Isno-Open/OpenSuperRF/enclosures/render_capot.png

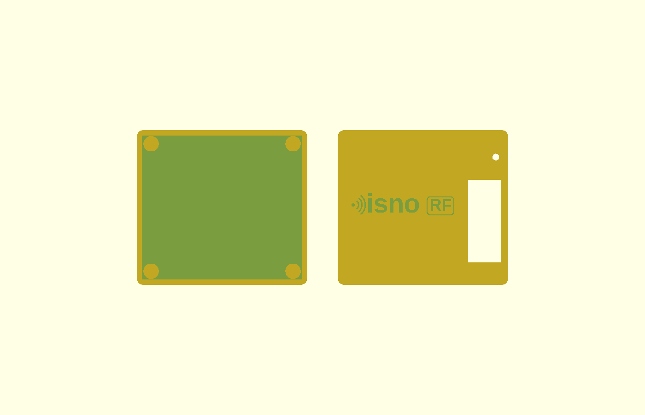
enclosures/render_capot.png
