Isno-Open/OpenSuperRF/enclosures/render_super.png

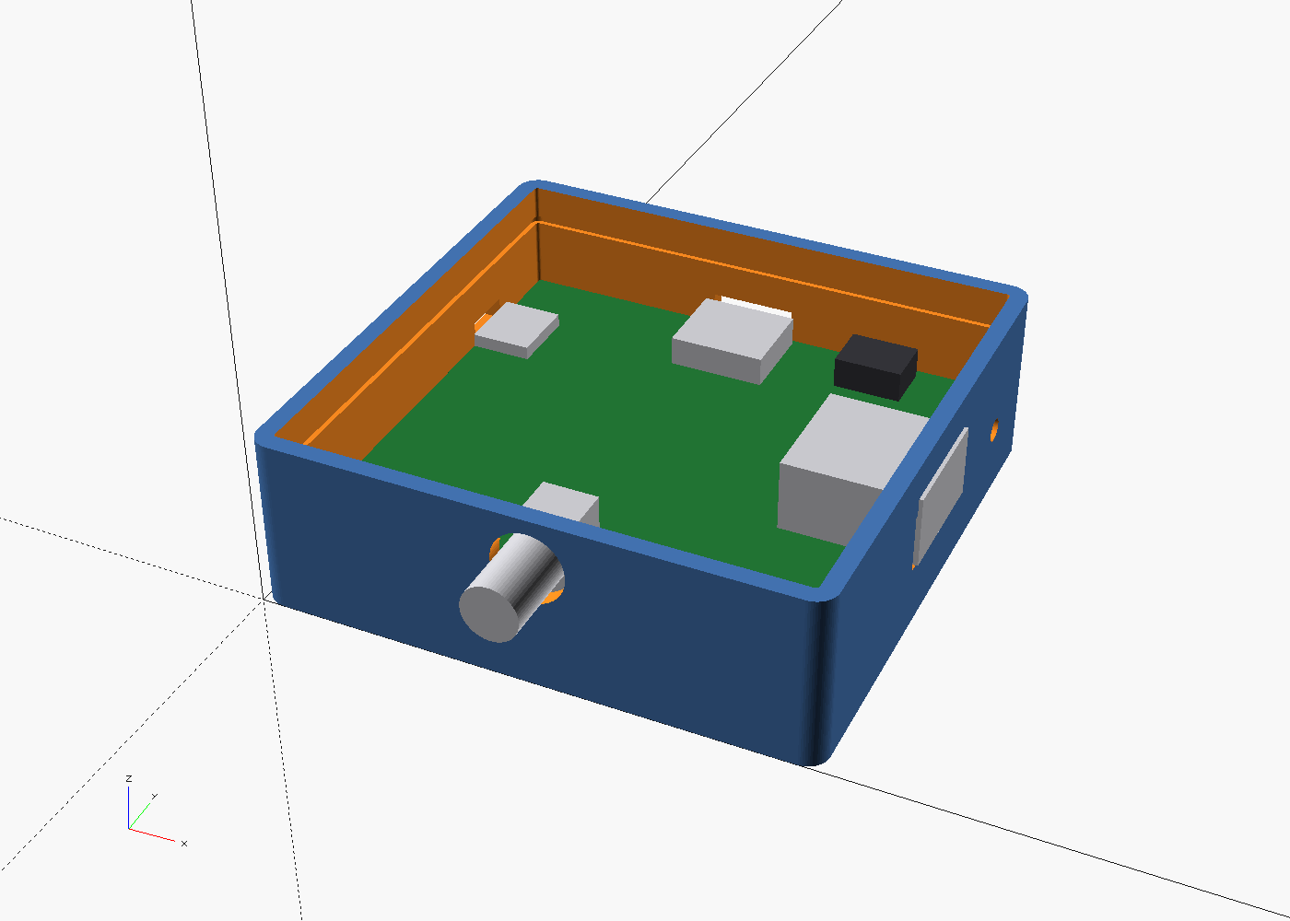
enclosures/render_super.png
