Isno-Open/OpenSuperRF/fab/isno-super-3d.png

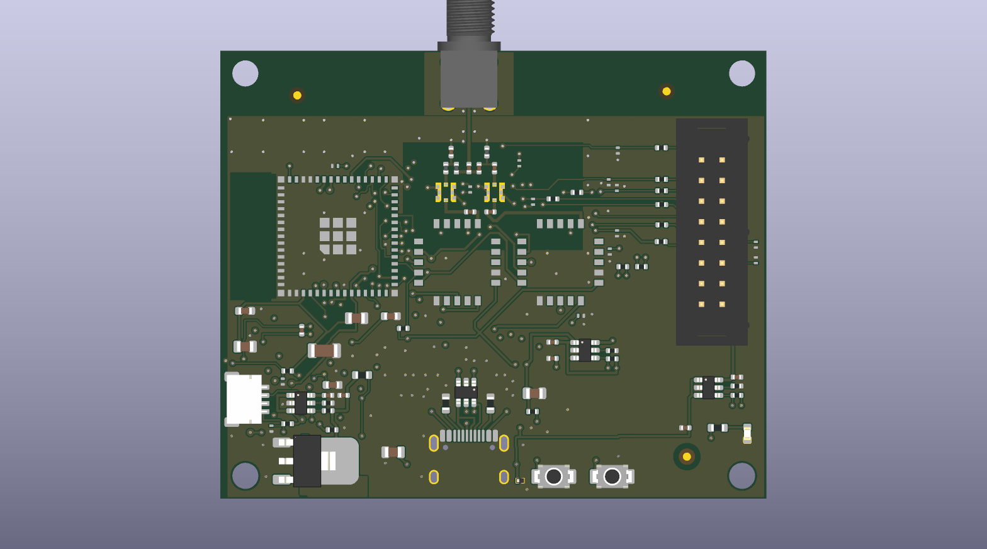
fab/isno-super-3d.png
