Isno-Open/OpenSuperRF/images/boitier-super.png

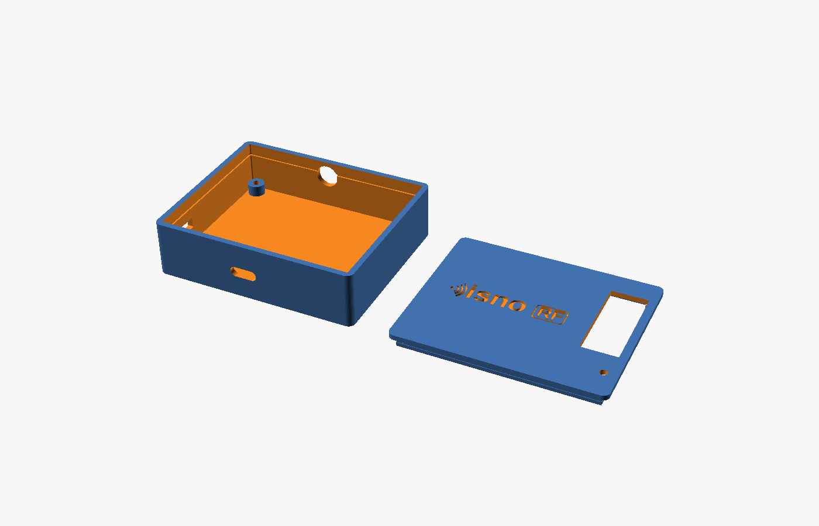
images/boitier-super.png
