Isno-Open/OpenSuperRF/images/isno-super-evt-dos.webp

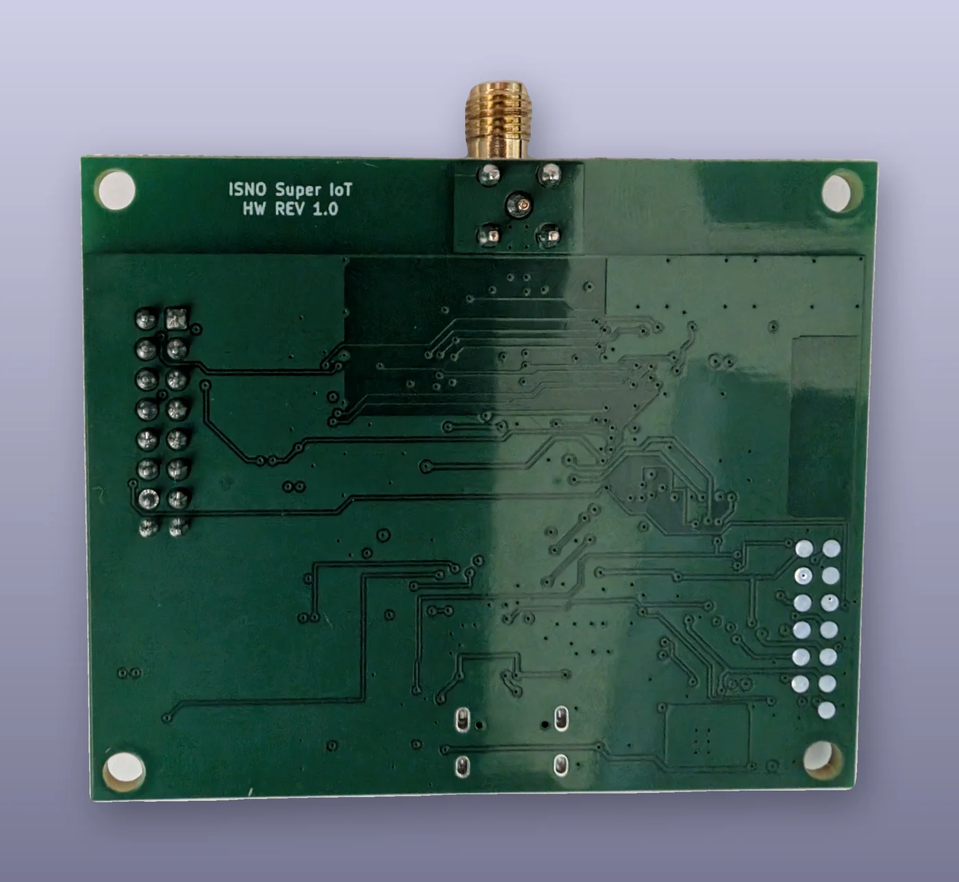
images/isno-super-evt-dos.webp
