Isno-Open/OpenSuperRF/images/render_named.png

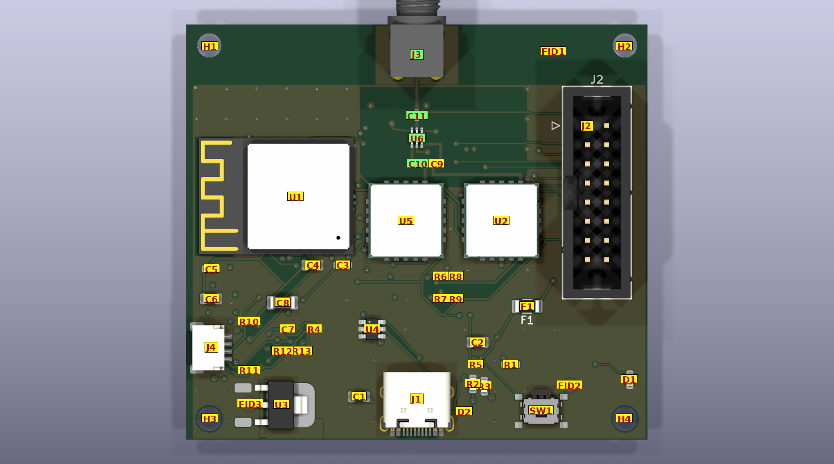
images/render_named.png
