Isno-Open/OpenSuperRF/images/rendu-3d-final.png

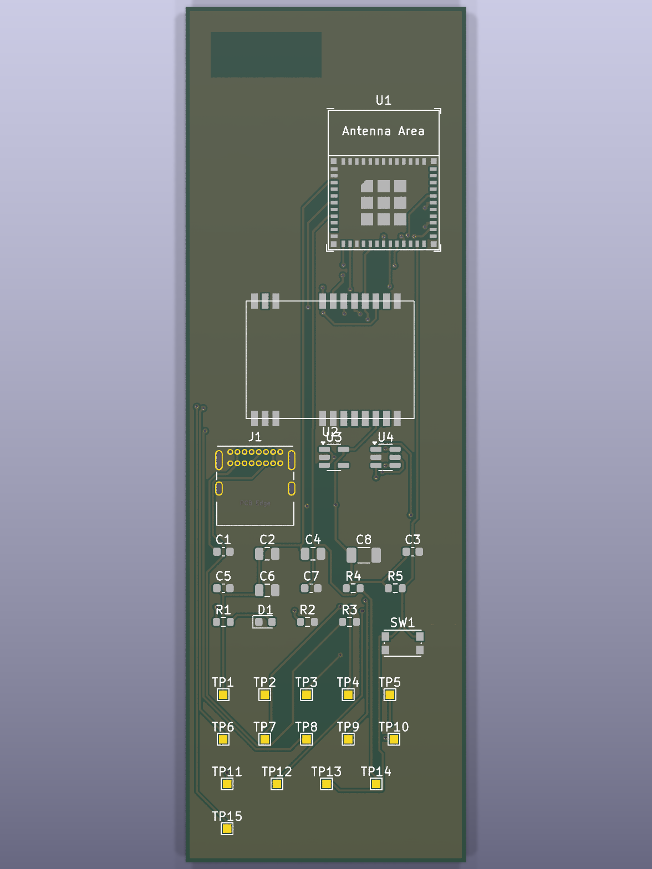
images/rendu-3d-final.png
