Isno-Open/OpenSuperRF/images/super-bottom.png

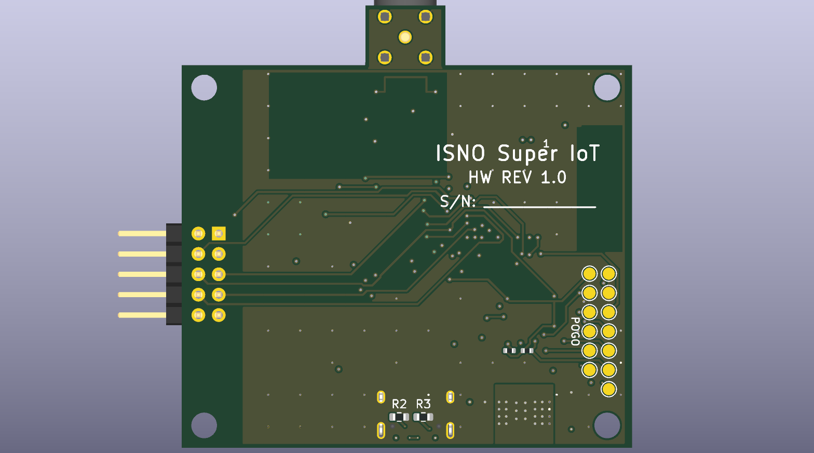
images/super-bottom.png
