Isno-Open/OpenSuperRF/images/super-dos.png

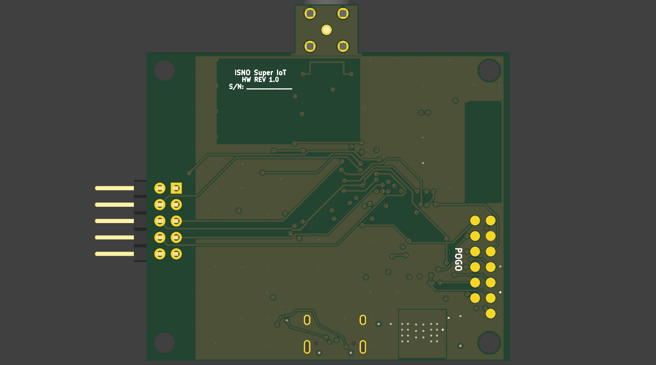
images/super-dos.png
