Isno-Open/OpenSuperRF/images/super-face.png

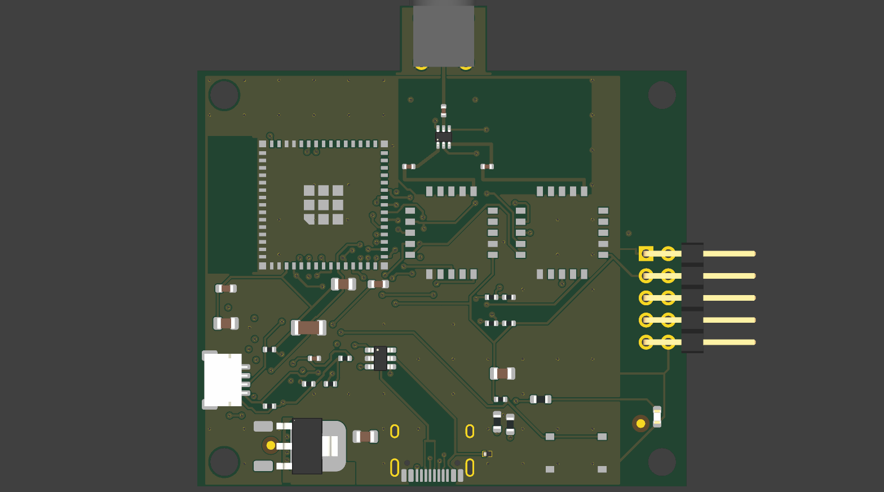
images/super-face.png
