Isno-Open/OpenSuperRF/images/super-top.png

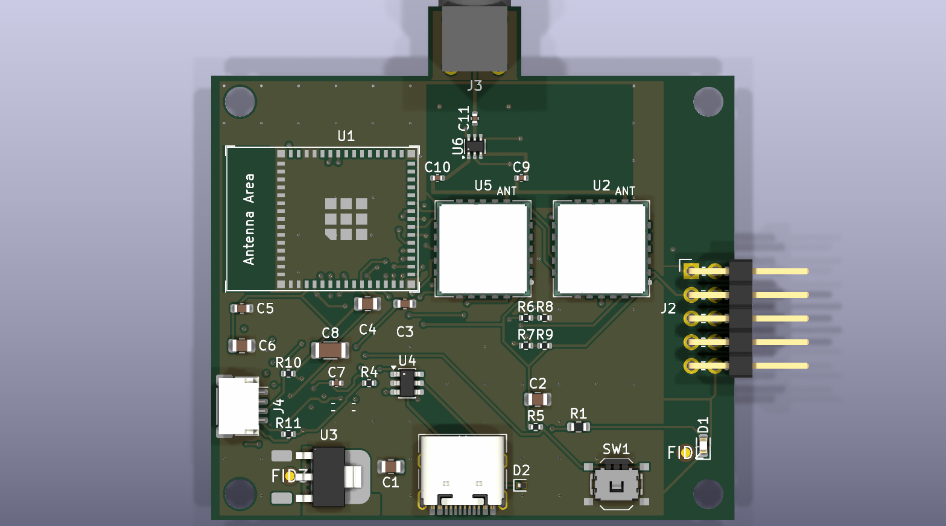
images/super-top.png
