Isno-Open/OpenSuperRF/docs/openprofalux-bom.csv

Reference | Value | Footprint | QUANTITY
C1 | 1uF | Capacitor_SMD:C_0603_1608Metric | 1
C2 | 22uF | Capacitor_SMD:C_0805_2012Metric | 1
C3,C5,C7 | 100nF | Capacitor_SMD:C_0603_1608Metric | 3
C4,C6 | 10uF | Capacitor_SMD:C_0805_2012Metric | 2
C8 | 47uF | Capacitor_SMD:C_1206_3216Metric | 1
D1 | LED | LED_SMD:LED_0603_1608Metric | 1
J1 | USB_C_Receptacle_USB2.0_16P | Connector_USB:USB_C_Receptacle_GCT_USB4085 | 1
R1 | 330 | Resistor_SMD:R_0603_1608Metric | 1
R2,R3 | 5.1k | Resistor_SMD:R_0603_1608Metric | 2
R4,R5 | 10k | Resistor_SMD:R_0603_1608Metric | 2
SW1 | BOOT | Button_Switch_SMD:SW_Push_1P1T_NO_CK_KMR2 | 1
TP1 | +3V3 | TestPoint:TestPoint_Pad_1.0x1.0mm | 1
TP2 | GND | TestPoint:TestPoint_Pad_1.0x1.0mm | 1
TP3 | SCK | TestPoint:TestPoint_Pad_1.0x1.0mm | 1
TP4 | MISO | TestPoint:TestPoint_Pad_1.0x1.0mm | 1
TP5 | MOSI | TestPoint:TestPoint_Pad_1.0x1.0mm | 1
TP6 | CSN | TestPoint:TestPoint_Pad_1.0x1.0mm | 1
TP7 | GDO0 | TestPoint:TestPoint_Pad_1.0x1.0mm | 1
TP8 | GDO2 | TestPoint:TestPoint_Pad_1.0x1.0mm | 1
TP9 | DP | TestPoint:TestPoint_Pad_1.0x1.0mm | 1
TP10 | DM | TestPoint:TestPoint_Pad_1.0x1.0mm | 1
TP11 | TXD | TestPoint:TestPoint_Pad_1.0x1.0mm | 1
TP12 | RXD | TestPoint:TestPoint_Pad_1.0x1.0mm | 1
TP13 | BOOT | TestPoint:TestPoint_Pad_1.0x1.0mm | 1
TP14 | EN | TestPoint:TestPoint_Pad_1.0x1.0mm | 1
TP15 | IO0 | TestPoint:TestPoint_Pad_1.0x1.0mm | 1
U1 | ESP32-C3-MINI-1 | Espressif:ESP32-C3-MINI-1 | 1
U2 | E07-900M10S | OpenProfalux:E07-900M10S | 1
U3 | AP2112K-3.3 | Package_TO_SOT_SMD:SOT-23-5 | 1
U4 | USBLC6-2SC6 | Package_TO_SOT_SMD:SOT-23-6 | 1
