Isno-Open/OpenSuperRF/fab/isno-super-bom.csv

Comment | Designator | Footprint | LCSC Part #
10uF | C1,C4,C6 | C_0805_2012Metric | C15850
22uF | C2 | C_0805_2012Metric | C45783
100nF | C3,C5 | C_0603_1608Metric | C14663
1uF | C7 | C_0603_1608Metric | C29936
47uF | C8 | C_1206_3216Metric | C96123
100pF | C9,C10,C11 | C_0402_1005Metric | C1546
4.7uF | C12 | C_0402_1005Metric | C23733
7.0pF | C13 | C_0402_1005Metric | C161333
2.4pF | C14 | C_0402_1005Metric | C88889
2.7pF | C15 | C_0402_1005Metric | C76904
100nF | C16,C18,C20 | C_0402_1005Metric | C1525
1uF | C17,C19,C21 | C_0402_1005Metric | C52923
LED | D1 | LED_0603_1608Metric | C2290
ESD | D2 | D_SOD-882 | C85402
TVS_ESD | D3,D4,D5,D6,D7,D8,D9,D11,D12,D13,D14,D15,D16,D17 | Texas_DPY0002A_0.6x1mm_P0.65mm | C48260
USB-C | J1 | USB_C_Receptacle_HRO_TYPE-C-31-M-12 | C165948
mikroBUS IDC box 2x8 | J2 | IDC-Header_2x08_P2.54mm_Vertical | C492443
SMA RA THT 50R | J3 | BWSMA-KWE-Z001 | C496551
Qwiic | J4 | JST_SH_SM04B-SRSS-TB_1x04-1MP_P1.00mm_Horizontal | C160404
MS-156C3(20) | J5,J6 | CoaxialSwitch_Hirose_MS-156C3_Horizontal | C3173236
33nH | L1 | L_0402_1005Metric | C113114
20nH | L2 | L_0402_1005Metric | C2043868
9.1nH | L3 | L_0402_1005Metric | C113122
330 | R1 | R_0603_1608Metric | C23138
5.1k | R2,R3 | R_0603_1608Metric | C23186
10k | R4 | R_0603_1608Metric | C98220
10k | R5,R12,R13 | R_0402_1005Metric | C25744
2.2k | R10,R11 | R_0402_1005Metric | C25879
220k | R14 | R_0402_1005Metric | C25767
100k | R15,R17,R18,R19 | R_0402_1005Metric | C25741
150k | R16 | R_0402_1005Metric | C25755
330 | R20,R21,R22,R23,R24,R25,R26,R27,R28,R29 | R_0402_1005Metric | C25104
RESET | SW1 | SW_Push_TS1088 | C720477
SW push | SW2 | SW_Push_TS1088 | C720477
ESP32-S3 | U1 | ESP32-S3-MINI-1 | C2913206
E07-868 | U2 | E07-900MM10S | C5844212
AP2114D | U3 | TO-252-2 | C460311
USBLC6 | U4 | SOT-23-6 | C7519
E07-433 | U5 | E07-900MM10S | C5844213
SGM2553 | U6,U7,U8 | SOT-23-6 | C699882
