Isno-Open/OpenSuperRF/enclosures/boitier_super.stl

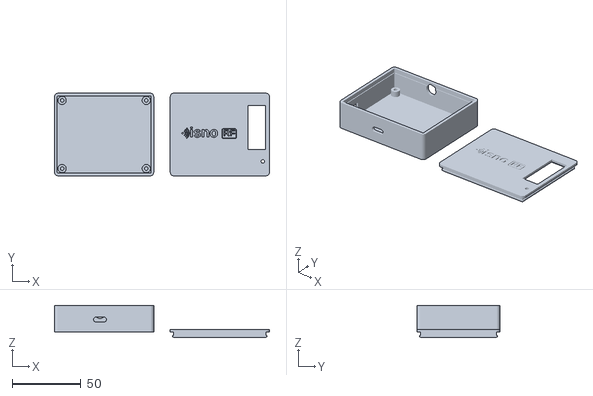
[picture p19: CAD file, 2026-10-26]
enclosures/boitier_super.stl
156.4 x 60.1 x 23.6
