Isno-Open/OpenSuperRF/docs/isno-super-v1.0-schematic.pdf

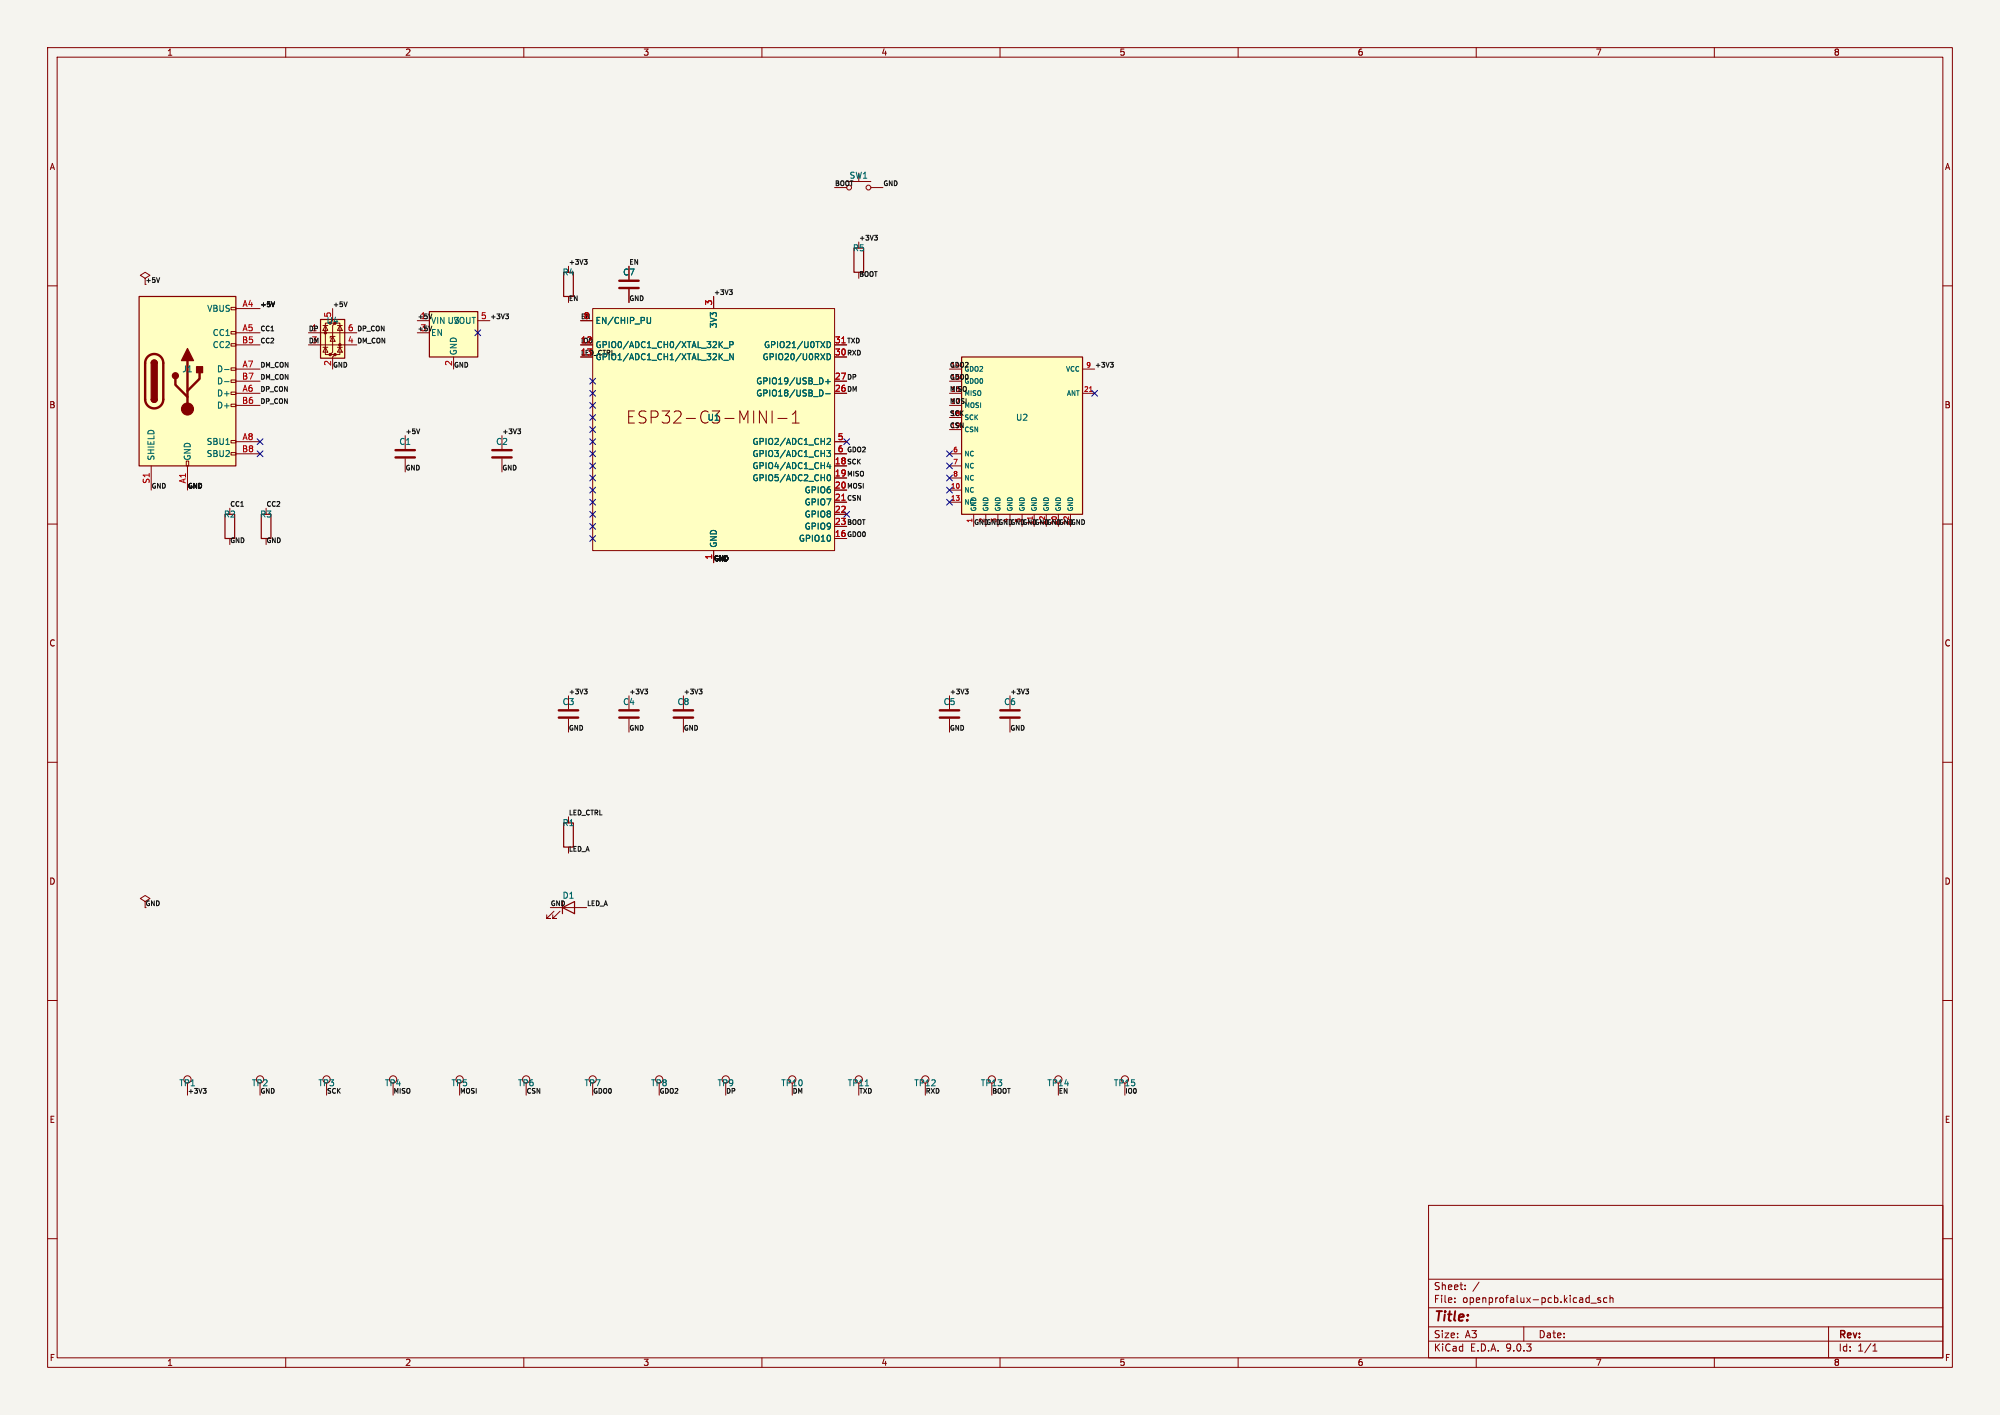
[picture p20: page 1]

5 GND 11 GND 12 GND 20 GND 22 VCC 9 ANT 21 U2 C8 R2 C3 C1 R3 C4 D1 C5 TP1 TP2 TP4 R1 TP3 TP5 SHIELD S1 GND A1 VBUS A4 CC1 A5 CC2 B5 D- A7 D- B7 D+ A6 D+ B6 SBU1 A8 SBU2 B8
+5V GND

Id: 1/1 Title: File: openprofalux-pcb.kicad_sch Sheet: /
