Isno-Open/OpenSuperRF/hardware/super/isno-super-v1.0.kicad_pcb

## KiCad design hardware/super/isno-super-v1.0.kicad_pcb (2026-10-26)

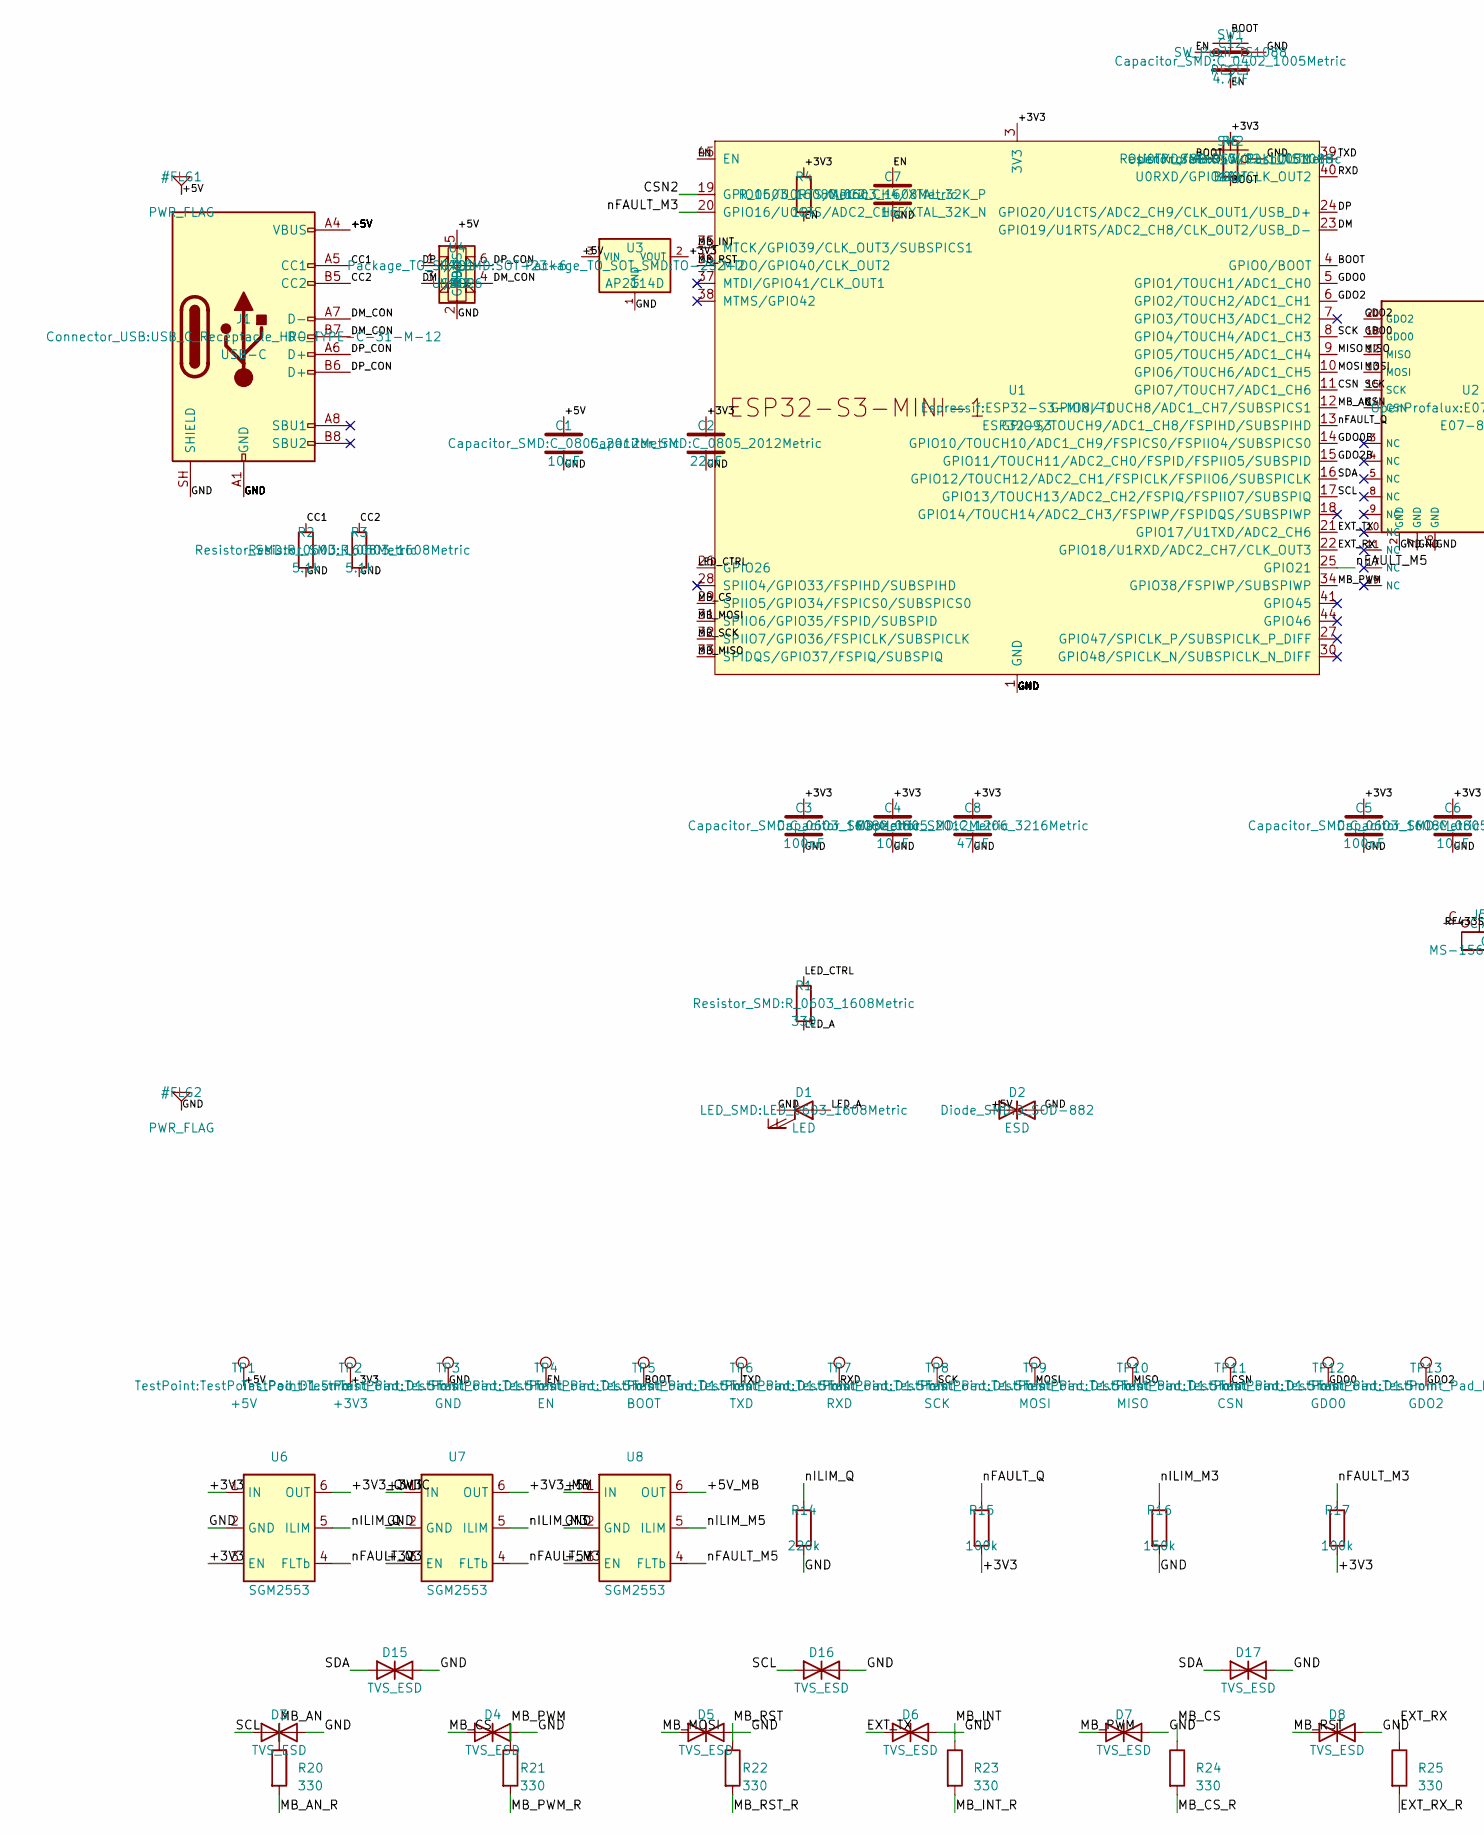
[picture p21: schematic isno-super-v1.0.kicad_sch, part in row 1, column 1]

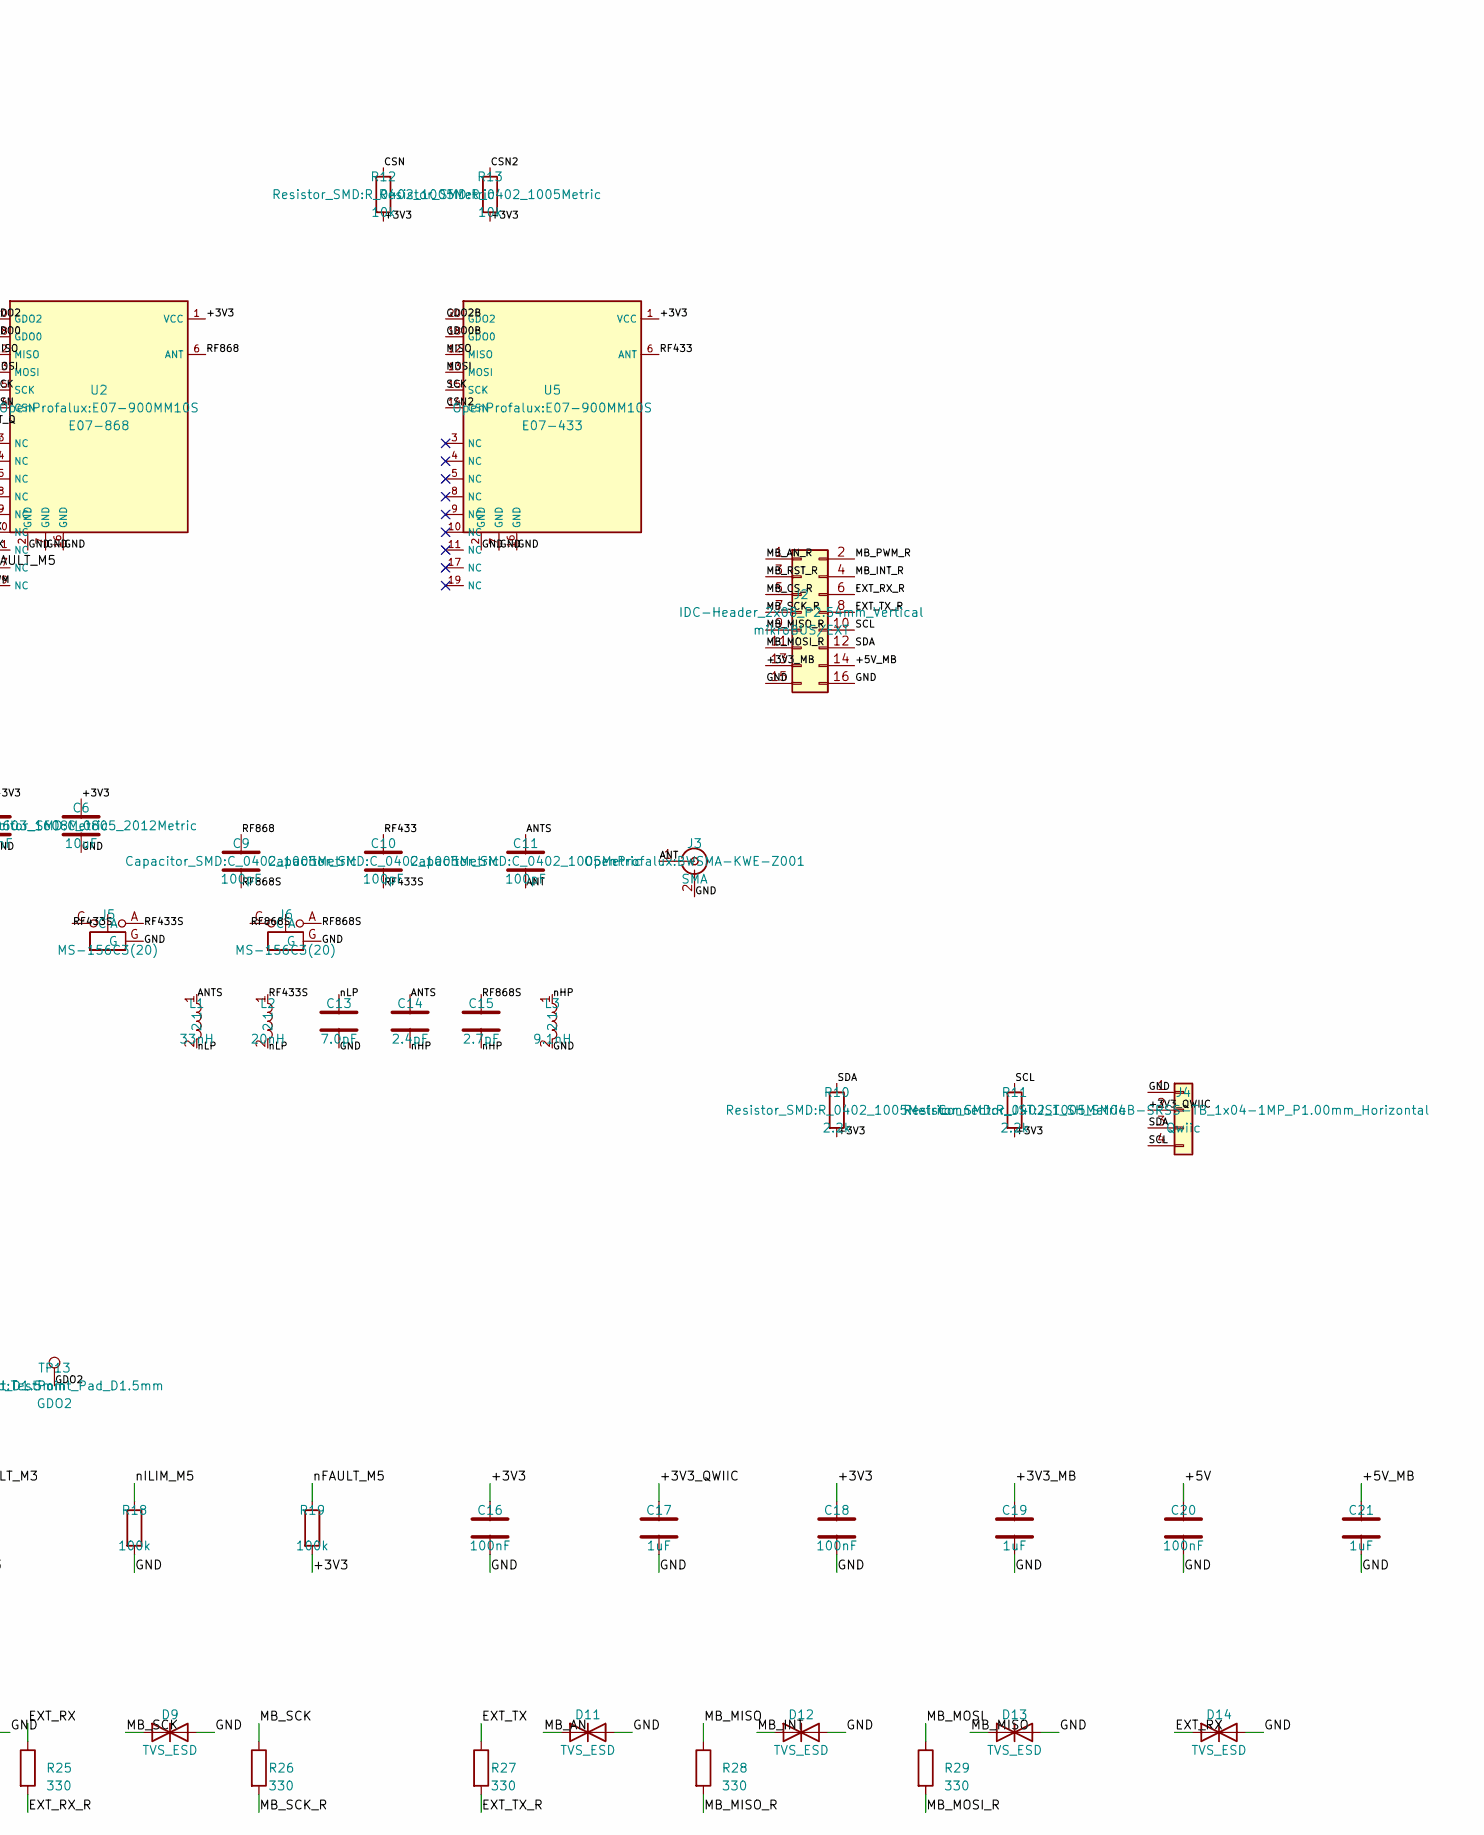
[picture p22: schematic isno-super-v1.0.kicad_sch, part in row 1, column 2]

Parts:
C1, C4, C6: 10uF; C_0805_2012Metric
C2: 22uF; C_0805_2012Metric
C3, C5: 100nF; C_0603_1608Metric
C7: 1uF; C_0603_1608Metric
C8: 47uF; C_1206_3216Metric
C9, C10, C11: 100pF; C_0402_1005Metric
C12: 4.7uF; C_0402_1005Metric
C13: 7.0pF; C_0402_1005Metric
C14: 2.4pF; C_0402_1005Metric
C15: 2.7pF; C_0402_1005Metric
C16, C18, C20: 100nF; C_0402_1005Metric
C17, C19, C21: 1uF; C_0402_1005Metric
D1: LED; LED_0603_1608Metric
D2: ESD; D_SOD-882
D3, D4, D5, D6, D7, D8, D9, D11, D12, D13, D14, D15, D16, D17: TVS_ESD; Texas_DPY0002A_0.6x1mm_P0.65mm
J1: USB-C; USB_C_Receptacle_HRO_TYPE-C-31-M-12
J2: mikroBUS/EXT; IDC-Header_2x08_P2.54mm_Vertical
J3: SMA; BWSMA-KWE-Z001
J4: Qwiic; JST_SH_SM04B-SRSS-TB_1x04-1MP_P1.00mm_Horizontal
J5, J6: MS-156C3(20); CoaxialSwitch_Hirose_MS-156C3_Horizontal
L1: 33nH; L_0402_1005Metric
L2: 20nH; L_0402_1005Metric
L3: 9.1nH; L_0402_1005Metric
R1: 330; R_0603_1608Metric
R2, R3: 5.1k; R_0603_1608Metric
R4: 10k; R_0603_1608Metric
R5, R12, R13: 10k; R_0402_1005Metric
R10, R11: 2.2k; R_0402_1005Metric
R14: 220k; R_0402_1005Metric
R15, R17, R18, R19: 100k; R_0402_1005Metric
R16: 150k; R_0402_1005Metric
R20, R21, R22, R23, R24, R25, R26, R27, R28, R29: 330; R_0402_1005Metric
SW1: RESET; SW_Push_TS1088
SW2: BOOT; SW_Push_TS1088
TP1: +5V; TestPoint_Pad_D1.5mm
TP2: +3V3; TestPoint_Pad_D1.5mm
TP3: GND; TestPoint_Pad_D1.5mm
TP4: EN; TestPoint_Pad_D1.5mm
TP5: BOOT; TestPoint_Pad_D1.5mm
TP6: TXD; TestPoint_Pad_D1.5mm
TP7: RXD; TestPoint_Pad_D1.5mm
TP8: SCK; TestPoint_Pad_D1.5mm
TP9: MOSI; TestPoint_Pad_D1.5mm
TP10: MISO; TestPoint_Pad_D1.5mm
TP11: CSN; TestPoint_Pad_D1.5mm
TP12: GDO0; TestPoint_Pad_D1.5mm
TP13: GDO2; TestPoint_Pad_D1.5mm
U1: ESP32-S3; ESP32-S3-MINI-1
U2: E07-868; E07-900MM10S
U3: AP2114D; TO-252-2
U4: USBLC6; SOT-23-6
U5: E07-433; E07-900MM10S
U6, U7, U8: SGM2553; SOT-23-6

Connections:
+3V3: C2.1, C3.1, C4.1, C5.1, C6.1, C8.1, C16.1, C18.1, R4.1, R5.1, R10.2, R11.2, R12.2, R13.2, R15.2, R17.2, R19.2, TP2.1, U1.3 (3V3), U2.1 (VCC), U3.2 (VOUT), U5.1 (VCC), U6.1 (IN), U6.3 (EN), U7.1 (IN), U7.3 (EN)
+3V3_MB: C19.1, J2.13, U7.6 (OUT)
+3V3_QWIIC: C17.1, J4.2, U6.6 (OUT)
+5V: C1.1, C20.1, D2.1 (A1), J1.A4 (VBUS), J1.A9 (VBUS), J1.B4 (VBUS), J1.B9 (VBUS), TP1.1, U3.3 (VIN), U4.5 (VBUS), U8.1 (IN), U8.3 (EN)
+5V_MB: C21.1, J2.14, U8.6 (OUT)
ANT: C11.2, J3.1 (In)
ANTS: C11.1, C14.1, L1.1
BOOT: C12.1, R5.2, SW2.1, TP5.1, U1.4 (GPIO0/BOOT)
CC1: J1.A5 (CC1), R2.1
CC2: J1.B5 (CC2), R3.1
CSN: R12.1, TP11.1, U1.11 (GPIO7/TOUCH7/ADC1_CH6), U2.14 (CSN)
CSN2: R13.1, U1.19 (GPIO15/U0RTS/ADC2_CH4/XTAL_32K_P), U5.14 (CSN)
DM: U1.23 (GPIO19/U1RTS/ADC2_CH8/CLK_OUT2/USB_D-), U4.3 (I/O2)
DM_CON: J1.A7 (D-), J1.B7 (D-), U4.4 (I/O2)
DP: U1.24 (GPIO20/U1CTS/ADC2_CH9/CLK_OUT1/USB_D+), U4.1 (I/O1)
DP_CON: J1.A6 (D+), J1.B6 (D+), U4.6 (I/O1)
EN: C7.1, C12.2, R4.2, SW1.1, TP4.1, U1.45 (EN)
EXT_RX: D14.1 (A1), R25.1, U1.22 (GPIO18/U1RXD/ADC2_CH7/CLK_OUT3)
EXT_RX_R: J2.6, R25.2
EXT_TX: D6.1 (A1), R27.1, U1.21 (GPIO17/U1TXD/ADC2_CH6)
EXT_TX_R: J2.8, R27.2
GDO0: TP12.1, U1.5 (GPIO1/TOUCH1/ADC1_CH0), U2.18 (GDO0)
GDO0B: U1.14 (GPIO10/TOUCH10/ADC1_CH9/FSPICS0/FSPIIO4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), U5.18 (GDO0)
GDO2: TP13.1, U1.6 (GPIO2/TOUCH2/ADC1_CH1), U2.20 (GDO2)
GDO2B: U1.15 (GPIO11/TOUCH11/ADC2_CH0/FSPID/FSPIIO5/S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), U5.20 (GDO2)
GND: C1.2, C2.2, C3.2, C4.2, C5.2, C6.2, C7.2, C8.2, C13.2, C16.2, C17.2, C18.2, C19.2, C20.2, C21.2, D1.1 (K), D2.2 (A2), D3.2 (A2), D4.2 (A2), D5.2 (A2), D6.2 (A2), D7.2 (A2), D8.2 (A2), D9.2 (A2), D11.2 (A2), D12.2 (A2), D13.2 (A2), D14.2 (A2), D15.2 (A2), D16.2 (A2), D17.2 (A2), J1.A1 (GND), J1.A12 (GND), J1.B1 (GND), J1.B12 (GND), J1.SH (SHIELD), J2.15, J2.16, J3.2 (Ext), J4.1, J4.MP, J5.G, J5.G1, J5.G2, J6.G, J6.G1, J6.G2, L3.2, R2.2, R3.2, R14.2, R16.2, R18.2, SW1.2, SW2.2, TP3.1, U1.1 (GND), U1.2 (GND), U1.42 (GND), U1.43 (GND), U1.46 (GND), U1.47 (GND), U1.48 (GND), U1.49 (GND), U1.50 (GND), U1.51 (GND), U1.52 (GND), U1.53 (GND), U1.54 (GND), U1.55 (GND), U1.56 (GND), U1.57 (GND), U1.58 (GND), U1.59 (GND), U1.60 (GND), U1.61 (GND), U1.62 (GND), U1.63 (GND), U1.64 (GND), U1.65 (GND), U2.2 (GND), U2.7 (GND), U2.16 (GND), U3.1 (GND), U4.2 (GND), U5.2 (GND), U5.7 (GND), U5.16 (GND), U6.2 (GND), U7.2 (GND), U8.2 (GND)
LED_A: D1.2 (A), R1.2
LED_CTRL: R1.1, U1.26 (GPIO26)
MB_AN: D11.1 (A1), R20.1, U1.12 (GPIO8/TOUCH8/ADC1_CH7/SUBSPICS1)
MB_AN_R: J2.1, R20.2
MB_CS: D4.1 (A1), R24.1, U1.29 (SPIIO5/GPIO34/FSPICS0/SUBSPICS0)
MB_CS_R: J2.5, R24.2
MB_INT: D12.1 (A1), R23.1, U1.35 (MTCK/GPIO39/CLK_OUT3/SUBSPICS1)
MB_INT_R: J2.4, R23.2
MB_MISO: D13.1 (A1), R28.1, U1.33 (SPIDQS/GPIO37/FSPIQ/SUBSPIQ)
MB_MISO_R: J2.9, R28.2
MB_MOSI: D5.1 (A1), R29.1, U1.31 (SPIIO6/GPIO35/FSPID/SUBSPID)
MB_MOSI_R: J2.11, R29.2
MB_PWM: D7.1 (A1), R21.1, U1.34 (GPIO38/FSPIWP/SUBSPIWP)
MB_PWM_R: J2.2, R21.2
MB_RST: D8.1 (A1), R22.1, U1.36 (MTDO/GPIO40/CLK_OUT2)
MB_RST_R: J2.3, R22.2
MB_SCK: D9.1 (A1), R26.1, U1.32 (SPIIO7/GPIO36/FSPICLK/SUBSPICLK)
MB_SCK_R: J2.7, R26.2
MISO: TP10.1, U1.9 (GPIO5/TOUCH5/ADC1_CH4), U2.12 (MISO), U5.12 (MISO)
MOSI: TP9.1, U1.10 (GPIO6/TOUCH6/ADC1_CH5), U2.13 (MOSI), U5.13 (MOSI)
RF433: C10.1, U5.6 (ANT)
RF433S: C10.2, J5.1, J5.A, J5.C, L2.1
RF868: C9.1, U2.6 (ANT)
RF868S: C9.2, C15.1, J6.1, J6.A, J6.C
RXD: TP7.1, U1.40 (U0RXD/GPIO44/CLK_OUT2)
SCK: TP8.1, U1.8 (GPIO4/TOUCH4/ADC1_CH3), U2.15 (SCK), U5.15 (SCK)
SCL: D3.1 (A1), D16.1 (A1), J2.10, J4.4, R11.1, U1.17 (GPIO13/TOUCH13/ADC2_CH2/FSPIQ/FSPIIO7/S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)
SDA: D15.1 (A1), D17.1 (A1), J2.12, J4.3, R10.1, U1.16 (GPIO12/TOUCH12/ADC2_CH1/FSPICLK/FSPIIO6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)
TXD: TP6.1, U1.39 (U0TXD/GPIO43/CLK_OUT1)
nFAULT_M3: R17.1, U1.20 (GPIO16/U0CTS/ADC2_CH5/XTAL_32K_N), U7.4 (FLTb)
nFAULT_M5: R19.1, U1.25 (GPIO21), U8.4 (FLTb)
nFAULT_Q: R15.1, U1.13 (GPIO9/TOUCH9/ADC1_CH8/FSPIHD/SUBSPIHD), U6.4 (FLTb)
nHP: C14.2, C15.2, L3.1
nILIM_M3: R16.1, U7.5 (ILIM)
nILIM_M5: R18.1, U8.5 (ILIM)
nILIM_Q: R14.1, U6.5 (ILIM)
nLP: C13.1, L1.2, L2.2

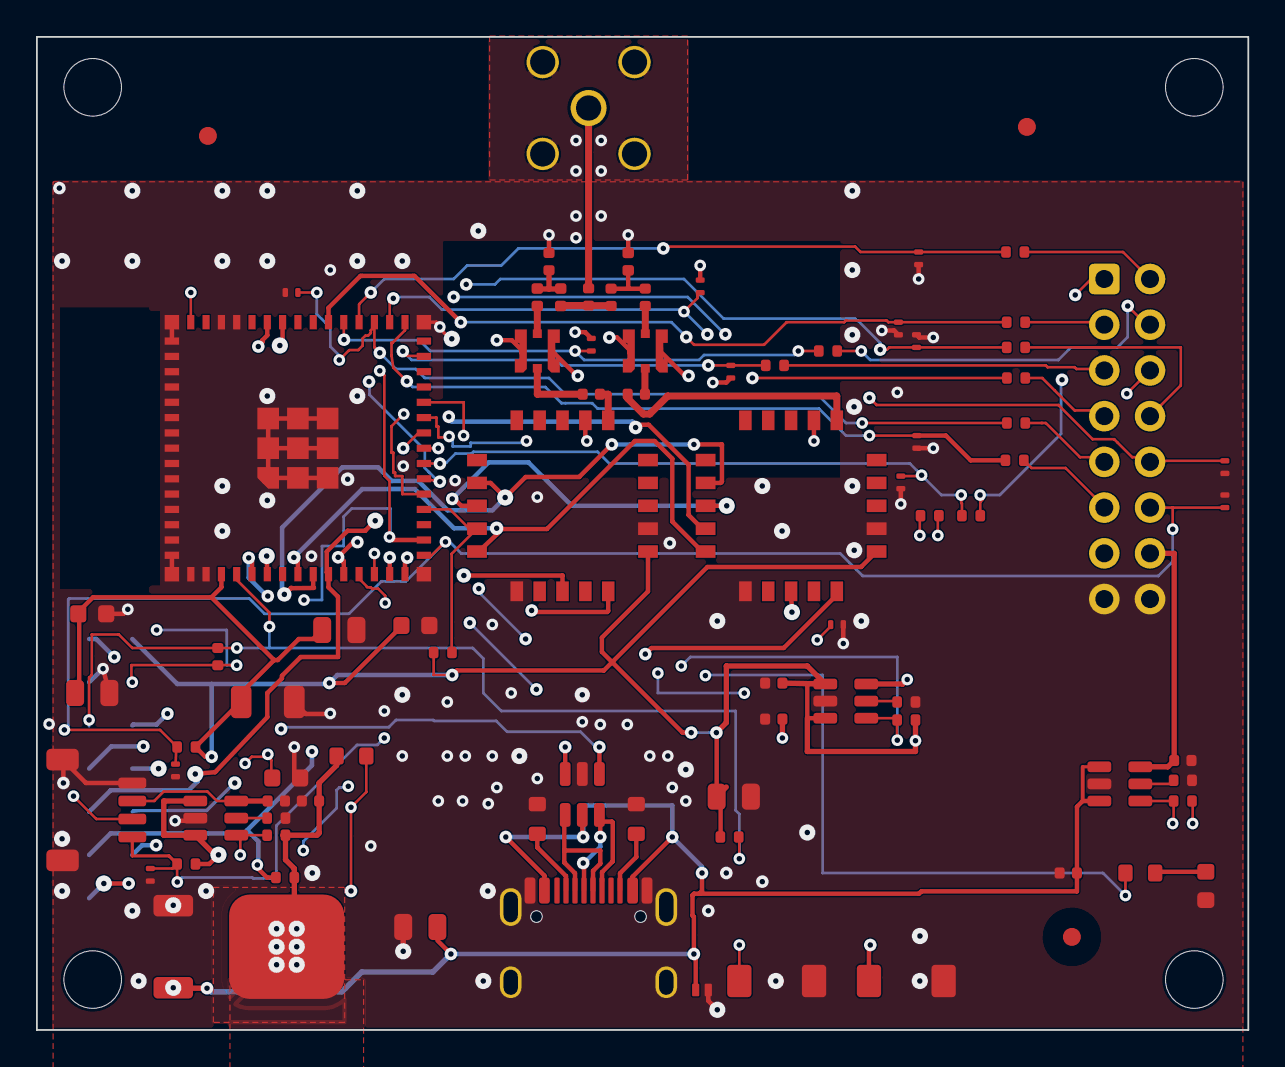
[picture p23: board isno-super-v1.0.kicad_pcb from above]

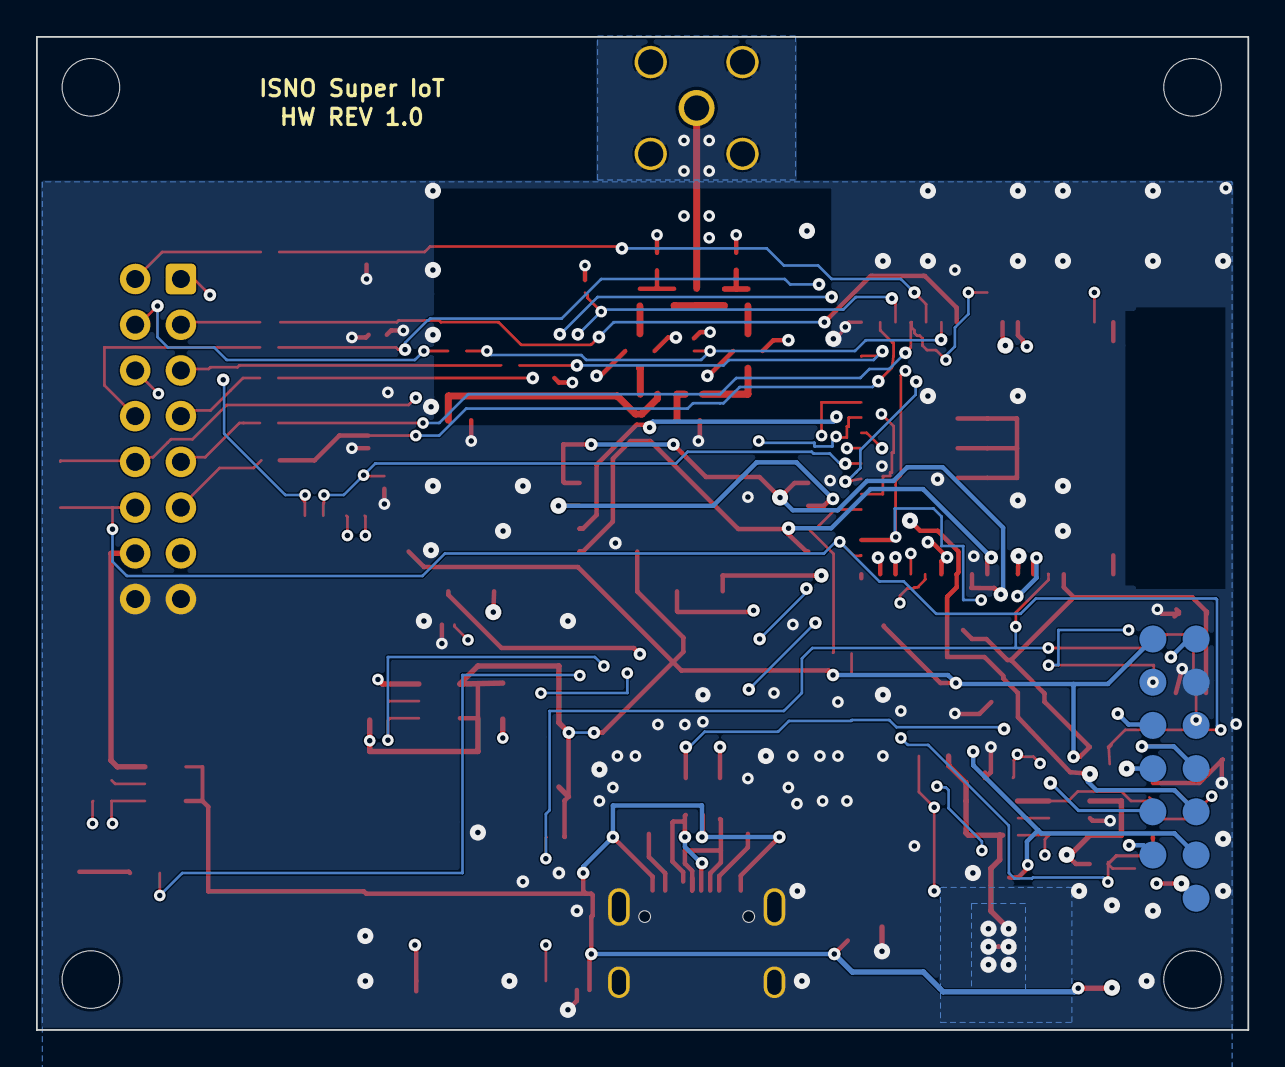
[picture p24: board isno-super-v1.0.kicad_pcb from below]

Board: 4 copper layers, 67.3 x 55.2 mm, 101 parts (13 on the bottom side), 63 nets.

Other parts of the board:
FID1, FID2, FID3: Fiducial
H1, H2, H3, H4: M3; MountingHole_3.2mm_M3
