Isno-Open/OpenSuperRF/hardware/accessories/mikrobus-riser/mikrobus-riser.kicad_pcb

## KiCad design hardware/accessories/mikrobus-riser/mikrobus-riser.kicad_pcb (2026-10-26)

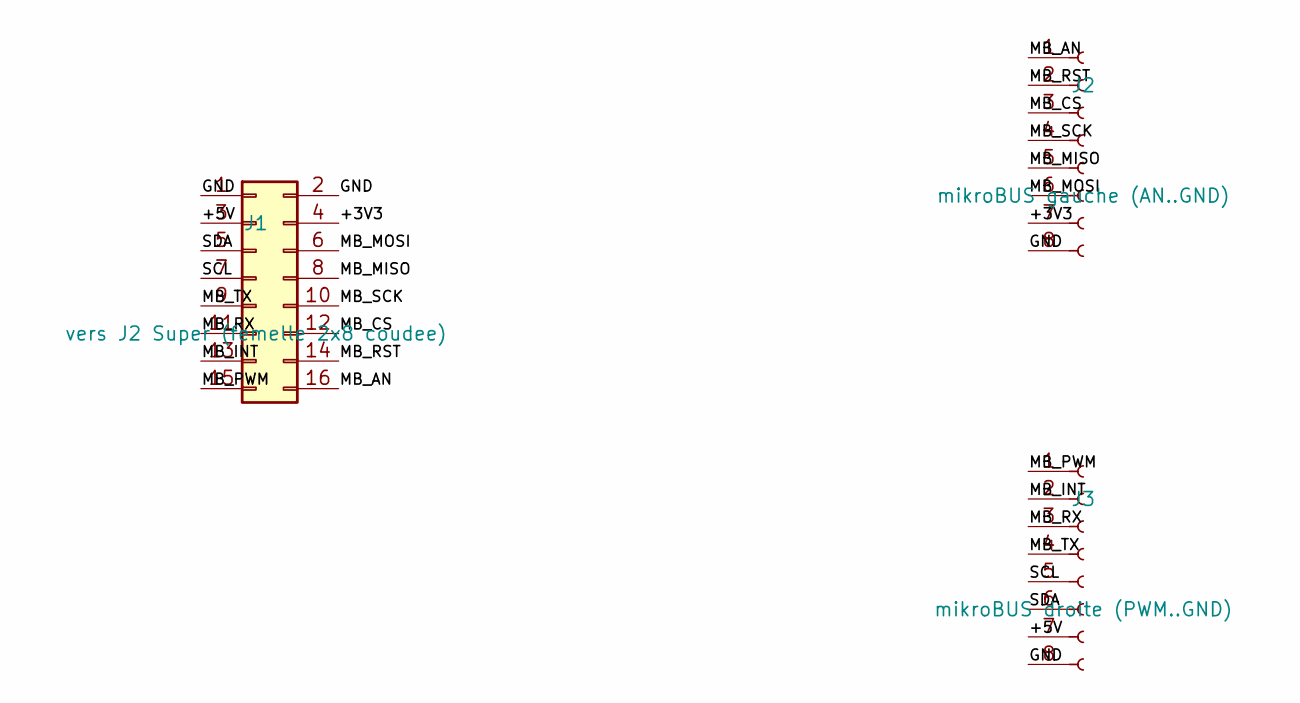
[picture p25: schematic mikrobus-riser.kicad_sch, Riser mikroBUS pour ISNO Super]

Parts:
J1: vers J2 Super (femelle 2x8 coudee); PinSocket_2x08_P2.54mm_Horizontal; LCSC C7509538
J2: mikroBUS gauche (AN..GND); PinSocket_1x08_P2.54mm_Vertical; LCSC C27438
J3: mikroBUS droite (PWM..GND); PinSocket_1x08_P2.54mm_Vertical; LCSC C27438

Connections:
+3V3: J1.4, J2.7
+5V: J1.3, J3.7
GND: J1.1, J1.2, J2.8, J3.8
MB_AN: J1.16, J2.1
MB_CS: J1.12, J2.3
MB_INT: J1.13, J3.2
MB_MISO: J1.8, J2.5
MB_MOSI: J1.6, J2.6
MB_PWM: J1.15, J3.1
MB_RST: J1.14, J2.2
MB_RX: J1.11, J3.3
MB_SCK: J1.10, J2.4
MB_TX: J1.9, J3.4
SCL: J1.7, J3.5
SDA: J1.5, J3.6

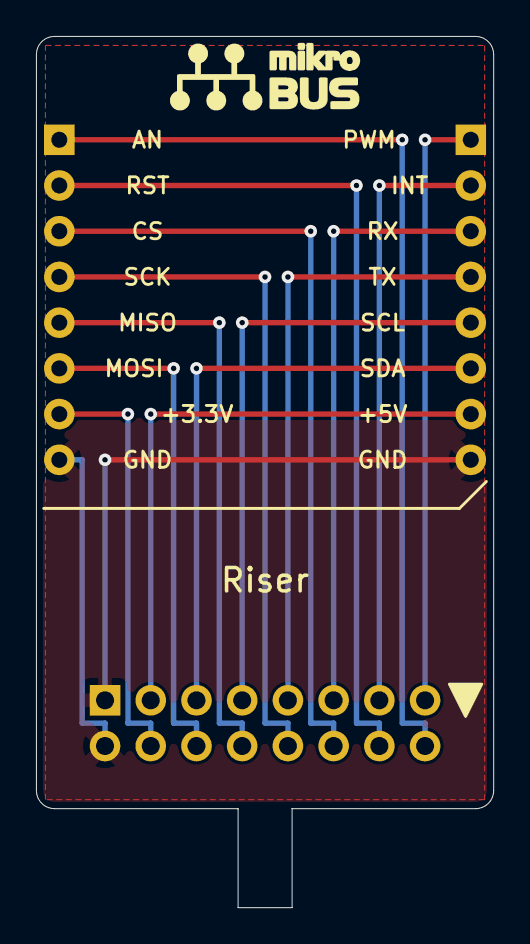
[picture p26: board mikrobus-riser.kicad_pcb from above]

Board: 2 copper layers, 25.4 x 48.4 mm, 3 parts (0 on the bottom side), 15 nets.
