Isno-Open/OpenSuperRF/(commit log)

2026-10-26 OpenSuperRF : design ouvert de la carte ISNO Super v1.0 (EVT)
    Carte radio ESP32-S3, 2x CC1101 433/868 MHz, diplexeur LC sur SMA unique, Qwiic, mikroBUS,
    USB-C. Version EVT fabriquee et mesuree (porteuses propres 868,2 / 433,9 MHz). Sources KiCad
    (carte + accessoires Riser et adaptateur), fab de l'EVT, schema PDF, mesures RF, photos.
    Licence CERN-OHL-S v2. Firmwares associes : OpenProfalux, OpenRFTest.
2026-10-26 README EN+FR : photo montage en tete, sections Boitier et Accessoires avec photos, lien precommande sur la v1.1, note sur OpenProfalux.pretty ; ajout du boitier imprimable (enclosures) et des photos 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
2026-10-26 README : retrait de la vue 3D du boitier (on garde la photo reelle et le STL)
2026-10-26 Points ouverts : ajout de KNOWN_ISSUES.md (dont J2 destructeur au cordon droit) + avertissement en tete des README
    Rend la publication honnete : les points ouverts de l'EVT sont marques, conformement au principe
    annonce dans l'article (ne pas publier un plan avec un piege non documente).
